ToyDr-W/STM32_orgel_ver1_4/README.md

## STM32_orgel_ver1_4

# 📦 [ARCHIVE / READ-ONLY] STM32 Electronic Music Box Project Backup

**This repository is a read-only archive for backup purposes. It is NOT an active workspace for collaborative development.**

* **Purpose:** To preserve and showcase the original, complete electronic music box project.
* **Structure:** 100% of the original development environment's hierarchy is fully maintained.
* **Source:** Re-hosted from the original author's Google Drive with official permission.

---

### 📦 本リポジトリについて（日本語）

このリポジトリは、開発者ご本家の了解を得て、Google ドライブで公開されているオリジナル版のファイルをそのまま保存した**バックアップ（展示スペース）**です。
約1400余りのファイルからなるプロジェクト一式を、階層構造を100%維持した状態で格納しています。

> [!NOTE]
> ### 📥 最新データのダウンロードについて（v1.2.0正式リリースまで）
> 開発元（名張市つつじが丘おもちゃ病院様）の公開ダウンロードファイルは随時更新されます。次のアップデートがあったときは、本リポジトリへの反映は しばらく様子を見て、安定後に **v1.2.0（安定版）** としてリリース予定です。
> 
> それまでの間、最新の回路図およびプログラム一式をダウンロードするには、
> [ここをクリックしてください。 ⬇️](https://github.com/ToyDr-W/STM32_orgel_ver1_4/archive/refs/heads/main.zip)
> ダウンロード（79.4 MBのZIPファイル）が直ちに開始されます。
>
> ---
>
> ### 📥 Downloading the Latest Data (Prior to v1.2.0 Official Release)
> The file made available for download by the developer (Nabari City Tsutsujigaoka Toy Hospital) is updated periodically. When a new update is released, it will not be immediately incorporated into this repository; instead, we will monitor it for a while, and once it has proven stable, we plan to release it as **v1.2.0 (stable version)**.
> 
> In the meantime, [please click here to download ⬇️](https://github.com/ToyDr-W/STM32_orgel_ver1_4/archive/refs/heads/main.zip) the latest circuit diagrams and the complete set of programs. The download (79.4 MB ZIP file) will begin immediately.
> 

---

### 🔗 開発者ご本家・オリジナルリソース (Original Resources)

最新情報や詳細な解説については、以下の公式ページをご確認ください。

* **開発者公式ブログ:** [名張市つつじが丘おもちゃ病院](https://tutujith.blog.fc2.com/)
* **解説記事:** [ＳＴＭ３２電子オルゴールVer1_4（ＳＰＩフラッシュのＩＳＰ書き込みのサポート）](https://tutujith.blog.fc2.com/blog-entry-1087.html)
* **オリジナル配布元:** [Google ドライブ - プロジェクト一式（ZIP）](https://drive.google.com/file/d/1_EQOB8y7ZNF8W41dpKjoThnxdAZjZsz2/view?usp=sharing)

---

## 🔄 改訂履歴 (Change Log)

<details>
<summary>クリックして詳細を展開 / Click to view details</summary>

### 📄 本リポジトリの更新情報
- **2026/10/17**: v1.0.1 （改版、安定版）2026/10/7 開発元の公開ダウンロードファイル更新を反映
- **2026/10/14**: v1.0.0 （GitHub開始時、安定版）2026/10/4 ＳＰＩフラッシュのＩＳＰ書き込みのサポート

</details>

---

### ⚠️ 注意事項 (Notice)

1. **Issue・Pull Requestについて:** アーカイブ目的のため、コードの修正提案やPull Requestは受け付けておりません。
2. **成果物の取り扱い:** 開発者様のブログ方針に準じ、複製・改変等はフリーですが、改変時はオリジナルと区別できるようにしてください。
