ToyDr-W/STM32_orgel_ver1_4/orgel1_4/wave/readme.txt

ＷＡＶファイルから音源データを生成する手順

①wav2dec.exe でＷＡＶファイルを１０進表現のテキストデータに変換する。
　ｂａｔファイル例　Piano_C3sample256.bat

②Ｅｘｃｅｌに喰わせて折れ線グラフ化し、波形を見る。
　取出したい１周期分のデータをトリミングする。
　Ｅｘｃｅｌファイル例　Piano_C3.xls

③sample256.exe でｄｗ疑似命令のアセンブラソースファイを作成する。
　ｂａｔファイル例　Piano_C3sample256.bat
