ToyDr-W/STM32_orgel_ver1_4/（ポート節約）画像/ＳＴＭ３２電子オルゴールVer1_4（ポート節約）Ｆ０３０Ｆ４Ｐ６ソフト実装ＳＰＩ全体.png

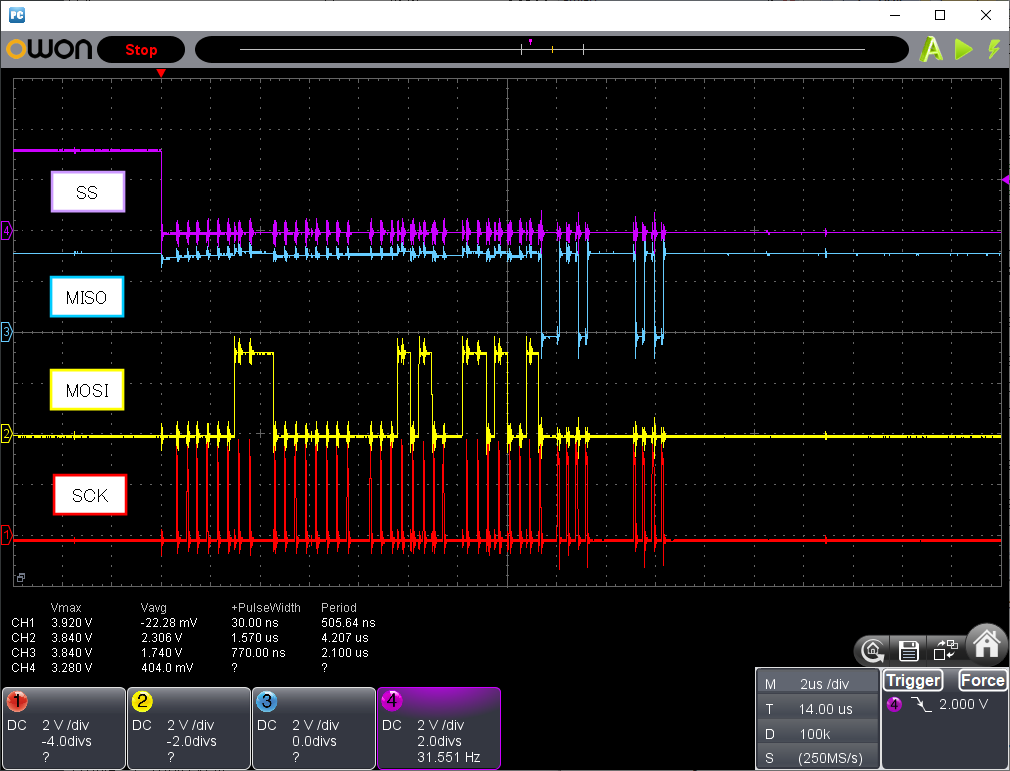
（ポート節約）画像/ＳＴＭ３２電子オルゴールVer1_4（ポート節約）Ｆ０３０Ｆ４Ｐ６ソフト実装ＳＰＩ全体.png
