ToyDr-W/STM32_orgel_ver1_4/（ポート節約）画像/ＳＴＭ３２電子オルゴールVer1_4（ポート節約）Ｆ１０３Ｃ６Ｔ６Ａ内蔵ＳＰＩ拡大２.png

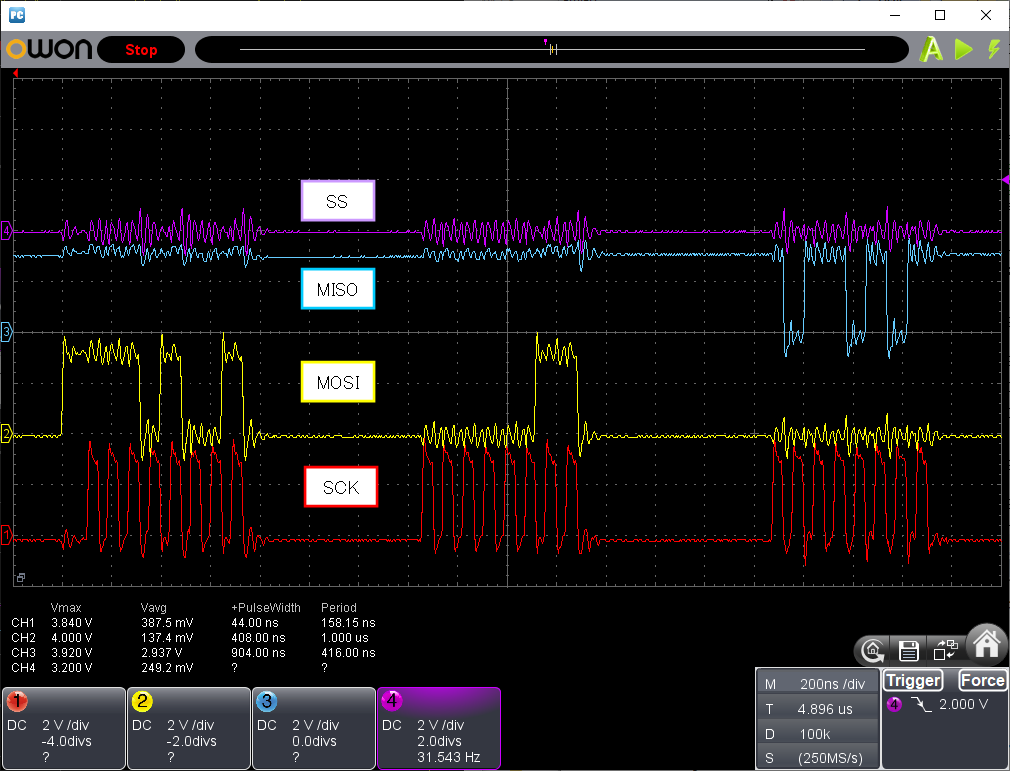
（ポート節約）画像/ＳＴＭ３２電子オルゴールVer1_4（ポート節約）Ｆ１０３Ｃ６Ｔ６Ａ内蔵ＳＰＩ拡大２.png
