ToyDr-W/STM32_orgel_ver1_4/（ポート節約）画像/ＳＴＭ３２電子オルゴールVer1_4（ポート節約）Ｆ１０３Ｃ６Ｔ６Ａ内蔵ＳＰＩ縮小.png

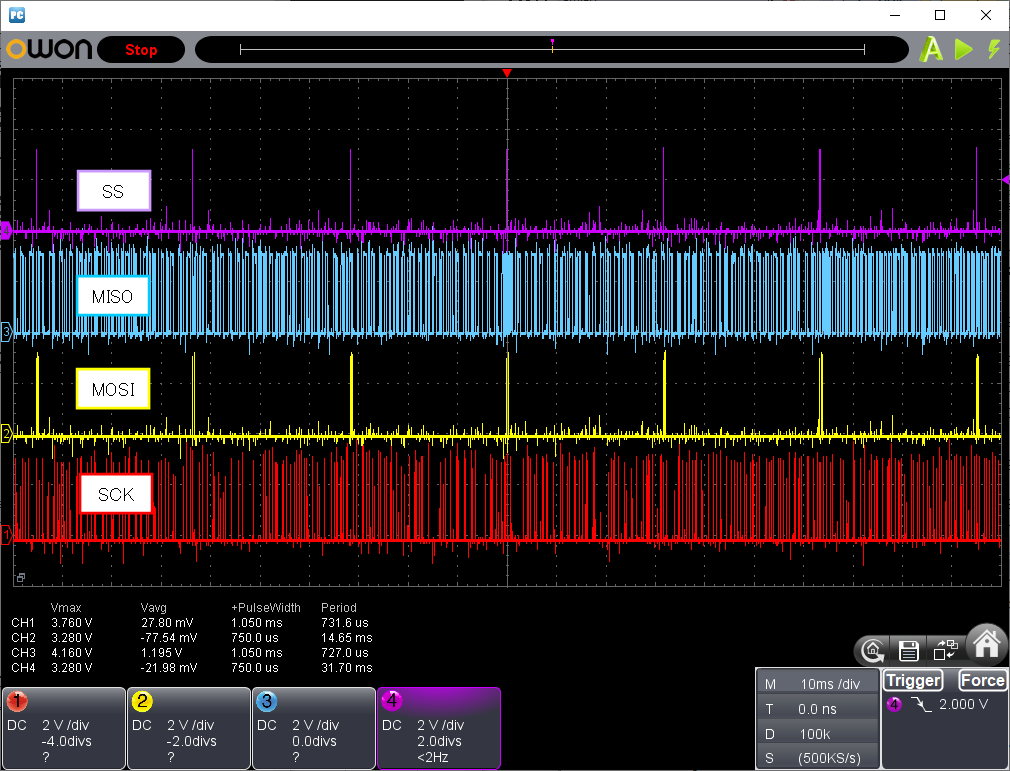
（ポート節約）画像/ＳＴＭ３２電子オルゴールVer1_4（ポート節約）Ｆ１０３Ｃ６Ｔ６Ａ内蔵ＳＰＩ縮小.png
