ToyDr-W/STM32_orgel_ver1_4/（ポート節約）画像/ＳＴＭ３２電子オルゴールVer1_4（ポート節約）Ｒｅａｄコマンドシーケンス.jpg

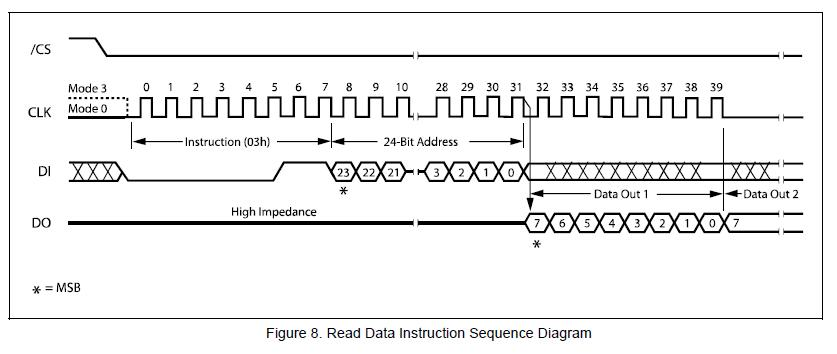
（ポート節約）画像/ＳＴＭ３２電子オルゴールVer1_4（ポート節約）Ｒｅａｄコマンドシーケンス.jpg
