ToyDr-W/STM32_orgel_ver1_4/（ＳＰＩフラッシュのＩＳＰ書込み）画像/ＳＴＭ３２電子オルゴールVer1_4（ＳＰＩフラッシュのＩＳＰ書込み）write実行結果.png

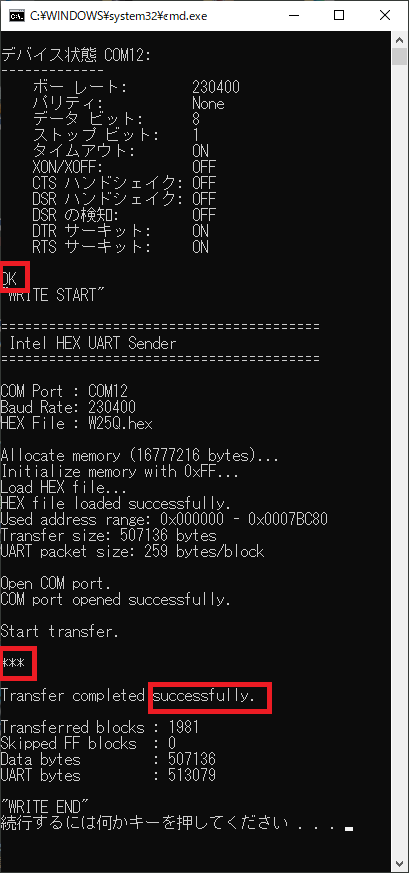
（ＳＰＩフラッシュのＩＳＰ書込み）画像/ＳＴＭ３２電子オルゴールVer1_4（ＳＰＩフラッシュのＩＳＰ書込み）write実行結果.png
