ToyDr-W/STM32_orgel_ver1_4/（ＳＰＩフラッシュのＩＳＰ書込み）画像/ＳＴＭ３２電子オルゴールVer1_4（ＳＰＩフラッシュのＩＳＰ書込み）構成.jpg

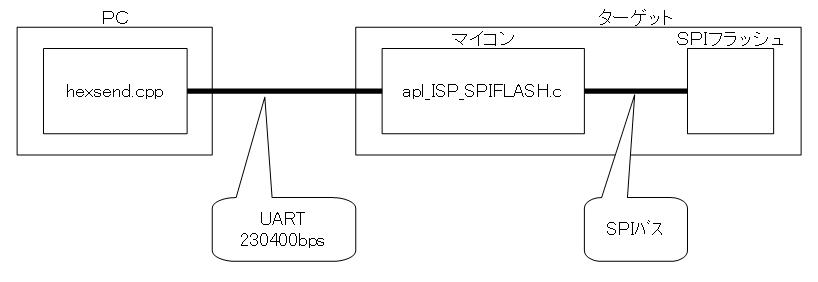
（ＳＰＩフラッシュのＩＳＰ書込み）画像/ＳＴＭ３２電子オルゴールVer1_4（ＳＰＩフラッシュのＩＳＰ書込み）構成.jpg
