ToyDr-W/STM32_orgel_ver1_4/（ＳＰＩ音声複数ｃｈで性能改善）画像/ＳＴＭ３２電子オルゴールVer1_4（ＳＰＩ音声複数ｃｈで性能改善）ＳＰＩ波形３.png

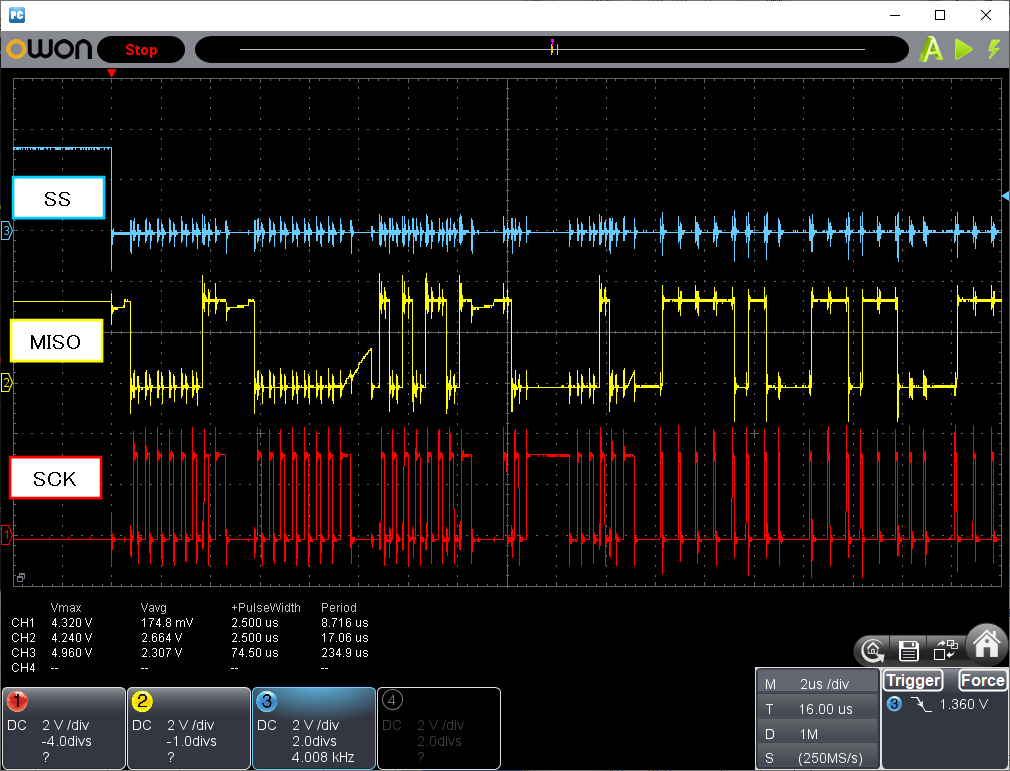
（ＳＰＩ音声複数ｃｈで性能改善）画像/ＳＴＭ３２電子オルゴールVer1_4（ＳＰＩ音声複数ｃｈで性能改善）ＳＰＩ波形３.png
