ToyDr-W/STM32_orgel_ver1_4/ＳＴＭ３２電子オルゴールVer1_4（ＳＴＭ３２Ｆ０３０Ｃ８Ｔ６完成基板）画像/ＳＴＭ３２電子オルゴールVer1_4（ＳＴＭ３２Ｆ０３０Ｃ８Ｔ６完成基板）基板３.JPG

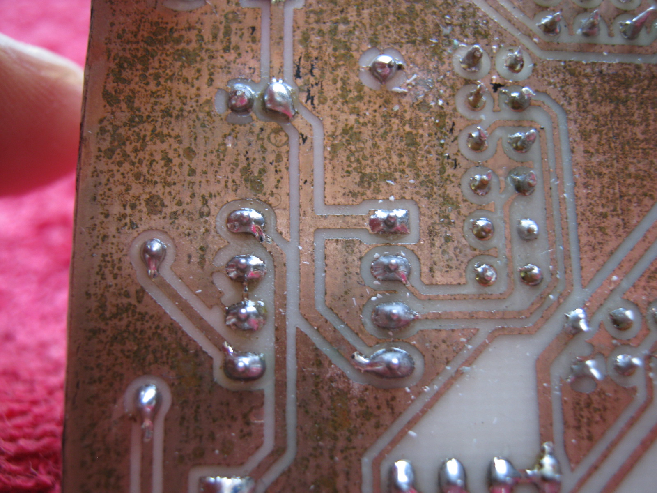
ＳＴＭ３２電子オルゴールVer1_4（ＳＴＭ３２Ｆ０３０Ｃ８Ｔ６完成基板）画像/ＳＴＭ３２電子オルゴールVer1_4（ＳＴＭ３２Ｆ０３０Ｃ８Ｔ６完成基板）基板３.JPG
