ToyDr-W/STM32_orgel_ver1_4/orgel1_4/tool_ikou_song/tool/Release/BuildLog.htm

ビルド ログ

| | リビルド 開始: プロジェクト: tool、構成: Release|Win32

コマンド ライン

一時ファイル "d:\ooizumi\STM\orgel1_3\tool_ikou_song\tool\Release\RSP000001582811144.rsp" を作成しています。内容 :
[
/O2 /Oi /GL /D "WIN32" /D "NDEBUG" /D "_CONSOLE" /D "_UNICODE" /D "UNICODE" /FD /EHsc /MD /Gy /Fo"Release\\" /Fd"Release\vc90.pdb" /W3 /c /Zi /TP .\tool.cpp
]
コマンド ライン "cl.exe @d:\ooizumi\STM\orgel1_3\tool_ikou_song\tool\Release\RSP000001582811144.rsp /nologo /errorReport:prompt" を作成しています。
一時ファイル "d:\ooizumi\STM\orgel1_3\tool_ikou_song\tool\Release\RSP000002582811144.rsp" を作成しています。内容 :
[
/OUT:"D:\ooizumi\STM\orgel1_3\tool_ikou_song\tool\Release\tool.exe" /INCREMENTAL:NO /MANIFEST /MANIFESTFILE:"Release\tool.exe.intermediate.manifest" /MANIFESTUAC:"level='asInvoker' uiAccess='false'" /DEBUG /PDB:"D:\ooizumi\STM\orgel1_3\tool_ikou_song\tool\Release\tool.pdb" /SUBSYSTEM:CONSOLE /OPT:REF /OPT:ICF /LTCG /DYNAMICBASE /NXCOMPAT /MACHINE:X86 kernel32.lib user32.lib gdi32.lib winspool.lib comdlg32.lib advapi32.lib shell32.lib ole32.lib oleaut32.lib uuid.lib odbc32.lib odbccp32.lib

".\Release\tool.obj"
]
コマンド ライン "link.exe @d:\ooizumi\STM\orgel1_3\tool_ikou_song\tool\Release\RSP000002582811144.rsp /NOLOGO /ERRORREPORT:PROMPT" を作成しています。
一時ファイル "d:\ooizumi\STM\orgel1_3\tool_ikou_song\tool\Release\RSP000003582811144.rsp" を作成しています。内容 :
[
/outputresource:".\Release\tool.exe;#1" /manifest

.\Release\tool.exe.intermediate.manifest
]
コマンド ライン "mt.exe @d:\ooizumi\STM\orgel1_3\tool_ikou_song\tool\Release\RSP000003582811144.rsp /nologo" を作成しています。
一時ファイル "d:\ooizumi\STM\orgel1_3\tool_ikou_song\tool\Release\BAT000004582811144.bat" を作成しています。内容 :
[
@echo マニフェスト リソースの最終更新日時: %TIME% (%DATE%) > .\Release\mt.dep
]
コマンド ライン "d:\ooizumi\STM\orgel1_3\tool_ikou_song\tool\Release\BAT000004582811144.bat" を作成しています。

出力ウィンドウ

| | コンパイルしています... tool.cpp リンクしています... コード生成しています。 コード生成が終了しました。 マニフェストを埋め込んでいます...

結果

| | ビルドログは "file://d:\ooizumi\STM\orgel1_3\tool_ikou_song\tool\Release\BuildLog.htm" に保存されました。 tool - エラー 0、警告 0
