ToyDr-W/STM32_orgel_ver1_4/orgel1_4/dev_PWM_F030F4.c

//==============================================
//PWM周期割込み処理
//==============================================
void TIM1_BRK_UP_TRG_COM_IRQHandler(void)
{
	short pcm;				//PCM値

//DBS_H;					//割込み処理開始を表示する
	TIM1->SR=0;				//割込みﾌﾗｸﾞをｸﾘｱする

	//PCM値を取得
	if(buf_read==buf_write) return;		//ﾃﾞｰﾀが無かったら飛ばす
	pcm=buf[buf_read];			//PCM値を取出す
	if(buf_read==(OUT_BUF_N-1)) buf_read=0;	//ﾊﾞｯﾌｧの後尾になったら先頭に戻す
	else buf_read++;			//ﾊﾞｯﾌｧを進める

//**********************************************
#ifdef PWM_3N_2_3				//正相3N､ﾌﾞﾘｯｼﾞ逆相2､ｺﾝﾌﾟﾘ逆相3
	//ﾃﾞｭｰﾃｨｻｲｸﾙを設定
#if BTL<2				//ｼﾝｸﾞﾙ･ｺﾝﾌﾟﾘ出力のとき
	TIM1->CCR3=((long)pcm+32768)*PWM_STEP/65536;
						//正相(逆相)を設定する

#else					//ﾌﾞﾘｯｼﾞ･ﾌﾞﾚｰｷ出力のとき
	if(pcm>0)				//正値のとき
	{
		TIM1->CCR2=0;			//逆相を止める
		TIM1->CCR3=(long)pcm*PWM_STEP/32768;
						//正相を設定する
	}
	else if(pcm<0)				//負値のとき
	{
		TIM1->CCR3=0;			//正相を止める
		TIM1->CCR2=(long)(-pcm)*PWM_STEP/32768;
						//逆相を設定する
	}
	else					//停止のとき
	{
		TIM1->CCR3=0;			//正相を止める
		TIM1->CCR2=0;			//逆相を止める
	}
#endif
#endif

//**********************************************
#ifdef PWM_3N_1N				//正相3N､ﾌﾞﾘｯｼﾞ逆相1N
	//ﾃﾞｭｰﾃｨｻｲｸﾙを設定
#if BTL==0				//ｼﾝｸﾞﾙ出力のとき
	TIM1->CCR3=((long)pcm+32768)*PWM_STEP/65536;
						//正相を設定する
#endif

#if BTL>1				//ﾌﾞﾘｯｼﾞ･ﾌﾞﾚｰｷ出力のとき
	if(pcm>0)				//正値のとき
	{
		TIM1->CCR1=0;			//逆相を止める
		TIM1->CCR3=(long)pcm*PWM_STEP/32768;
						//正相を設定する
	}
	else if(pcm<0)				//負値のとき
	{
		TIM1->CCR3=0;			//正相を止める
		TIM1->CCR1=(long)(-pcm)*PWM_STEP/32768;
						//逆相を設定する
	}
	else					//停止のとき
	{
		TIM1->CCR3=0;			//正相を止める
		TIM1->CCR1=0;			//逆相を止める
	}
#endif
#endif

//**********************************************
#ifdef PWM_3N					//ｼﾝｸﾞﾙ正相3N
	//ﾃﾞｭｰﾃｨｻｲｸﾙを設定
#if BTL==0				//ｼﾝｸﾞﾙ出力のとき
	TIM1->CCR3=((long)pcm+32768)*PWM_STEP/65536;
						//正相を設定する
#endif
#endif

//DBS_L;					//割込み処理終了を表示する
}


//==============================================
//PWM周期を待つ
//==============================================
static void wait_pwm(void)
{

	TIM1->SR=0;				//ｲﾍﾞﾝﾄﾌﾗｸﾞをｸﾘｱする
	while(!(TIM1->SR&TIM_SR_UIF));		//更新ｲﾍﾞﾝﾄを待つ
}


#ifdef	SLEEP_EN			//Sleep機能を実装するとき
//==============================================
//PWMを停止
//==============================================
static void dev_pwm_stop(void)
{

//DBG_C('\n');
//DBG_C('t');
	//DC更新を待つ
//DBG_C('1');
	wait_ms(10);				//10ms間はPWM割込み処理を回す
	TIM1->DIER=0;				//TIM1割込み禁止

//**********************************************
#ifdef PWM_3N_2_3				//正相3N､ﾌﾞﾘｯｼﾞ逆相2､ｺﾝﾌﾟﾘ逆相3
//DBG_C('a');
	//PWMを停止
//DBG_C('2');
	//ﾃﾞｭｰﾃｨｻｲｸﾙを設定
#if BTL==0				//ｼﾝｸﾞﾙ出力のとき
//DBG_C('3');
	while(TIM1->CCR3)			//DCが0になるまで繰返す
	{
		TIM1->CCR3--;			//ﾗﾝﾌﾟ下降
		wait_pwm();			//PWM周期を待つ
	}
#endif

#if BTL==1				//ｺﾝﾌﾟﾘ出力のとき
//DBG_C('4');
	TIM1->CCR3=PWM_STEP/2;			//DCを50%にする
	wait_pwm();				//PWM周期を待つ
	TIM1->CCER=0;				//PWM出力を止める
#endif

#if BTL>1				//ﾌﾞﾘｯｼﾞ･ﾌﾞﾚｰｷ出力のとき
//DBG_C('5');
	TIM1->CCR3=TIM1->CCR2=0;		//DCを0%にする
	wait_pwm();				//PWM周期を待つ
#endif

#if BTL==3				//ﾌﾞﾚｰｷ出力のとき
//DBG_C('6');
	TIM1->CCER&=~(TIM_CCER_CC3NP|TIM_CCER_CC2P);
						//正相と逆相をｱｸﾃｨﾌﾞHにする
#endif
#endif

//**********************************************
#ifdef PWM_3N_1N				//正相3N､ﾌﾞﾘｯｼﾞ逆相1N
//DBG_C('b');
	//PWMを停止
//DBG_C('2');
	//ﾃﾞｭｰﾃｨｻｲｸﾙを設定
#if BTL==0				//ｼﾝｸﾞﾙ出力のとき
//DBG_C('3');
	while(TIM1->CCR3)			//DCが0になるまで繰返す
	{
		TIM1->CCR3--;			//ﾗﾝﾌﾟ下降
		wait_pwm();			//PWM周期を待つ
	}
#endif
#if BTL==1				//ｺﾝﾌﾟﾘ出力のとき
//DBG_C('4');
	TIM1->CCR3=PWM_STEP/2;			//DCを50%にする
	wait_pwm();				//PWM周期を待つ
	TIM1->CCER=0;				//PWM出力を止める
#endif
#if BTL>1				//ﾌﾞﾘｯｼﾞ･ﾌﾞﾚｰｷ出力のとき
//DBG_C('5');
	TIM1->CCR3=TIM1->CCR1=0;		//DCを0%にする
	wait_pwm();				//PWM周期を待つ
#endif
#if BTL==3				//ﾌﾞﾚｰｷ出力のとき
//DBG_C('6');
	TIM1->CCER&=~(TIM_CCER_CC3NP|TIM_CCER_CC1NP);
						//正相と逆相をｱｸﾃｨﾌﾞHにする
#endif
#endif

//**********************************************
#ifdef PWM_3N					//ｼﾝｸﾞﾙ正相3N
//DBG_C('c');
	//PWMを停止
//DBG_C('2');
	//ﾃﾞｭｰﾃｨｻｲｸﾙを設定
#if BTL==0				//ｼﾝｸﾞﾙ出力のとき
//DBG_C('3');
	while(TIM1->CCR3)			//DCが0になるまで繰返す
	{
		TIM1->CCR3--;			//ﾗﾝﾌﾟ下降
		wait_pwm();			//PWM周期を待つ
	}
#endif
#endif

//DBG_C('9');
}
#endif


//==============================================
//PWMを再開
//==============================================
static void dev_pwm_start(void)
{

//DBG_C('\n');
//DBG_C('r');

//**********************************************
#ifdef PWM_3N_2_3				//正相3N､ﾌﾞﾘｯｼﾞ逆相2､ｺﾝﾌﾟﾘ逆相3
//DBG_C('a');
	//ﾃﾞｭｰﾃｨｻｲｸﾙを設定
#if BTL==0				//ｼﾝｸﾞﾙ出力のとき
//DBG_C('1');
	while(TIM1->CCR3++<PWM_STEP/2)		//ﾗﾝﾌﾟ上昇
	{
		wait_pwm();			//PWM周期を待つ
	}
#endif

#if BTL==1				//ｺﾝﾌﾟﾘ出力のとき
//DBG_C('2');
	TIM1->CCER|=TIM_CCER_CC3NP|TIM_CCER_CC3NE|TIM_CCER_CC3P|TIM_CCER_CC3E;
						//CH3NとCH3をｱｸﾃｨﾌﾞLでﾋﾟﾝ出力
#endif

#if BTL==3				//ﾌﾞﾚｰｷ出力のとき
//DBG_C('3');
	TIM1->CCER|=TIM_CCER_CC3NP|TIM_CCER_CC2P;
						//CH3NとCH2をｱｸﾃｨﾌﾞLにする
#endif
#endif

//**********************************************
#ifdef PWM_3N_1N				//正相3N､ﾌﾞﾘｯｼﾞ逆相1N
//DBG_C('b');
	//ﾃﾞｭｰﾃｨｻｲｸﾙを設定
#if BTL==0				//ｼﾝｸﾞﾙ出力のとき
//DBG_C('1');
	while(TIM1->CCR3++<PWM_STEP/2)		//ﾗﾝﾌﾟ上昇
	{
		wait_pwm();			//PWM周期を待つ
	}
#endif

#if BTL==3				//ﾌﾞﾚｰｷ出力のとき
//DBG_C('3');
	TIM1->CCER|=TIM_CCER_CC3NP|TIM_CCER_CC1NP;
						//CH3NとCH1NをｱｸﾃｨﾌﾞLにする
#endif
#endif

//**********************************************
#ifdef PWM_3N					//ｼﾝｸﾞﾙ正相3N
//DBG_C('c');
	//ﾃﾞｭｰﾃｨｻｲｸﾙを設定
#if BTL==0				//ｼﾝｸﾞﾙ出力のとき
//DBG_C('1');
	while(TIM1->CCR3++<PWM_STEP/2)		//ﾗﾝﾌﾟ上昇
	{
		wait_pwm();			//PWM周期を待つ
	}
#endif
#endif

	//PWMを再開
//DBG_C('8');
	TIM1->DIER=TIM_DIER_UIE;		//TIM1更新割込み許可
//DBG_C('9');
}


//==============================================
//PWM初期設定
//==============================================
static void pwm_init(void)
{

//DBG_C('<');
//DBG_C('p');
	//PWM設定(TIM1)
	RCC->APB2ENR|=RCC_APB2ENR_TIM1EN;	//TIM1にｸﾛｯｸ供給
	//TIM1->CR1のCMSﾋﾞｯﾄは00(ｴｯｼﾞｱﾗｲﾝﾄﾞﾓｰﾄﾞ)初期値
	//TIM1->SMCRのSMSﾋﾞｯﾄは000(ｽﾚｰﾌﾞﾓｰﾄﾞ無効)初期値
	//TIM1->PSCは0(ｸﾛｯｸ分周しない)初期値	//ｸﾛｯｸはSYSCLK
#if BTL==2				//ﾌﾞﾘｯｼﾞ出力のとき
	TIM1->ARR=PWM_STEP-1+PWM_DB_BRG;	//PWM周期(ﾃﾞｯﾄﾞﾊﾞﾝﾄﾞを考慮)
#else
	TIM1->ARR=PWM_STEP-1;			//PWM周期
#endif
	TIM1->BDTR|=TIM_BDTR_AOE;		//自動出力可
	TIM1->CNT=0;				//ｶｳﾝﾀをｸﾘｱ
	TIM1->CR1|=TIM_CR1_CEN;			//ｶｳﾝﾀ有効
	TIM1->CCMR2|=(TIM_CCMR2_OC3M_2|TIM_CCMR2_OC3M_1|TIM_CCMR2_OC3PE);
						//CH3をPWMﾓｰﾄﾞ1､ﾌﾟﾘﾛｰﾄﾞ有効

//**********************************************
#ifdef PWM_3N_2_3				//正相3N､ﾌﾞﾘｯｼﾞ逆相2､ｺﾝﾌﾟﾘ逆相3
//DBG_C('a');
#if BTL==0				//ｼﾝｸﾞﾙ出力のとき
//DBG_C('1');
	TIM1->CCER|=TIM_CCER_CC3NE;		//CH3Nをﾋﾟﾝ出力
	GPIO_AF(PWM_F_GPIO,PWM_F_BIT,PWM_F_AF);	//PWM正相を交代機能設定
#endif

#if BTL==1				//ｺﾝﾌﾟﾘ出力のとき
//DBG_C('2');
	TIM1->CCR3=PWM_STEP/2;			//CH3のDCを50%
	GPIO_AF(PWM_F_GPIO,PWM_F_BIT,PWM_F_AF);	//PWM正相を交代機能設定
	GPIO_AF(PWM_C_GPIO,PWM_C_BIT,PWM_C_AF);	//PWMｺﾝﾌﾟﾘを交代機能設定
#endif

#if BTL>1				//ﾌﾞﾘｯｼﾞ出力､ﾌﾞﾚｰｷ出力のとき
//DBG_C('3');
	TIM1->CCMR1|=(TIM_CCMR1_OC2M_2|TIM_CCMR1_OC2M_1|TIM_CCMR1_OC2PE);
						//CH2をPWMﾓｰﾄﾞ1､ﾌﾟﾘﾛｰﾄﾞ有効
	TIM1->CCER|=TIM_CCER_CC3NE|TIM_CCER_CC2E;
						//CH3NとCH2をﾋﾟﾝ出力
	GPIO_AF(PWM_F_GPIO,PWM_F_BIT,PWM_F_AF);	//PWM正相を交代機能設定
	GPIO_AF(PWM_R_GPIO,PWM_R_BIT,PWM_R_AF);	//PWM逆相を交代機能設定
#endif
#endif

//**********************************************
#ifdef PWM_3N_1N				//正相3N､ﾌﾞﾘｯｼﾞ逆相1N
//DBG_C('b');
#if BTL==0				//ｼﾝｸﾞﾙ出力のとき
//DBG_C('1');
	TIM1->CCER|=TIM_CCER_CC3NE;		//CH3Nをﾋﾟﾝ出力
	GPIO_AF(PWM_F_GPIO,PWM_F_BIT,PWM_F_AF);	//PWM正相を交代機能設定
#endif

#if BTL>1				//ﾌﾞﾘｯｼﾞ出力､ﾌﾞﾚｰｷ出力のとき
//DBG_C('3');
	TIM1->CCMR1|=(TIM_CCMR1_OC1M_2|TIM_CCMR1_OC1M_1|TIM_CCMR1_OC1PE);
						//CH1をPWMﾓｰﾄﾞ1､ﾌﾟﾘﾛｰﾄﾞ有効
	TIM1->CCER|=TIM_CCER_CC3NE|TIM_CCER_CC1NE;
						//CH3NとCH1Nをﾋﾟﾝ出力
	GPIO_AF(PWM_F_GPIO,PWM_F_BIT,PWM_F_AF);	//PWM正相を交代機能設定
	GPIO_AF(PWM_R_GPIO,PWM_R_BIT,PWM_R_AF);	//PWM逆相を交代機能設定
#endif
#endif

//**********************************************
#ifdef PWM_3N					//ｼﾝｸﾞﾙ正相3N
//DBG_C('c');
#if BTL==0				//ｼﾝｸﾞﾙ出力のとき
//DBG_C('1');
	TIM1->CCER|=TIM_CCER_CC3NE;		//CH3Nをﾋﾟﾝ出力
	GPIO_AF(PWM_F_GPIO,PWM_F_BIT,PWM_F_AF);	//PWM正相を交代機能設定
#endif
#endif

//DBG_C('9');
	//PWM周期割込み設定
	NVIC->ISER[0]=(1<<TIM1_BRK_UP_TRG_COM_IRQn);
						//TIM1割込み許可
//DBG_C('>');
	dev_pwm_start();			//PWMを開始する
}
