ToyDr-W/STM32_orgel_ver1_4/orgel1_4/dev_PWM_F030Cx.c

//==============================================
//PWM周期割込み処理
//==============================================
void TIM1_BRK_UP_TRG_COM_IRQHandler(void)
{
	short pcm;				//PCM値

//DBS_H;					//割込み処理開始を表示する
	TIM1->SR=0;				//割込みﾌﾗｸﾞをｸﾘｱする

	//PCM値を取得
	if(buf_read==buf_write) return;		//ﾃﾞｰﾀが無かったら飛ばす
	pcm=buf[buf_read];			//PCM値を取出す
	if(buf_read==(OUT_BUF_N-1)) buf_read=0;	//ﾊﾞｯﾌｧの後尾になったら先頭に戻す
	else buf_read++;			//ﾊﾞｯﾌｧを進める

	//ﾃﾞｭｰﾃｨｻｲｸﾙを設定

#if BTL<2				//ｼﾝｸﾞﾙ･ｺﾝﾌﾟﾘ出力のとき
	TIM1->CCR1=((long)pcm+32768)*PWM_STEP/65536;
						//正相(逆相)を設定する

#else					//ﾌﾞﾘｯｼﾞ･ﾌﾞﾚｰｷ出力のとき
	if(pcm>0)				//正値のとき
	{
		TIM1->CCR4=0;			//逆相を止める
		TIM1->CCR1=(long)pcm*PWM_STEP/32768;
						//正相を設定する
	}
	else if(pcm<0)				//負値のとき
	{
		TIM1->CCR1=0;			//正相を止める
		TIM1->CCR4=(long)(-pcm)*PWM_STEP/32768;
						//逆相を設定する
	}
	else					//停止のとき
	{
		TIM1->CCR1=0;			//正相を止める
		TIM1->CCR4=0;			//逆相を止める
	}
#endif
//DBS_L;					//割込み処理終了を表示する
}


//==============================================
//PWM周期を待つ
//==============================================
static void wait_pwm(void)
{

	TIM1->SR=0;				//ｲﾍﾞﾝﾄﾌﾗｸﾞをｸﾘｱする
	while(!(TIM1->SR&TIM_SR_UIF));		//更新ｲﾍﾞﾝﾄを待つ
}


#ifdef	SLEEP_EN			//Sleep機能を実装するとき
//==============================================
//PWMを停止
//==============================================
static void dev_pwm_stop(void)
{

//DBG_C('\n');
//DBG_C('s');
	//DC更新を待つ
//DBG_C('1');
	wait_ms(10);				//10ms間はPWM割込み処理を回す

	//PWMを停止
//DBG_C('2');
	TIM1->DIER=0;				//TIM1割込み禁止

	//ﾃﾞｭｰﾃｨｻｲｸﾙを設定

#if BTL==0				//ｼﾝｸﾞﾙ出力のとき
//DBG_C('3');
	while(TIM1->CCR1)			//DCが0になるまで繰返す
	{
		TIM1->CCR1--;			//ﾗﾝﾌﾟ下降
		wait_pwm();			//PWM周期を待つ
	}
#endif

#if BTL==1				//ｺﾝﾌﾟﾘ出力のとき
//DBG_C('4');
	TIM1->CCR1=PWM_STEP/2;			//DCを50%にする
	wait_pwm();				//PWM周期を待つ
	TIM1->CCER=0;				//PWM出力を止める
#endif

#if BTL>1				//ﾌﾞﾘｯｼﾞ･ﾌﾞﾚｰｷ出力のとき
//DBG_C('5');
	TIM1->CCR1=TIM1->CCR4=0;		//DCを0%にする
	wait_pwm();				//PWM周期を待つ
#endif

#if BTL==3				//ﾌﾞﾚｰｷ出力のとき
	TIM1->CCER&=~(TIM_CCER_CC1P|TIM_CCER_CC4P);
						//正相と逆相をｱｸﾃｨﾌﾞHにする
#endif
//DBG_C('6');
}
#endif


//==============================================
//PWMを再開
//==============================================
static void dev_pwm_start(void)
{

//DBG_C('\n');
//DBG_C('r');

	//ﾃﾞｭｰﾃｨｻｲｸﾙを設定
#if BTL==0				//ｼﾝｸﾞﾙ出力のとき
//DBG_C('1');
	while(TIM1->CCR1++<PWM_STEP/2)		//ﾗﾝﾌﾟ上昇
	{
		wait_pwm();			//PWM周期を待つ
	}
#endif

#if BTL==1				//ｺﾝﾌﾟﾘ出力のとき
//DBG_C('2');
	TIM1->CCER|=TIM_CCER_CC1E|TIM_CCER_CC1NE;
						//正相と逆相をﾋﾟﾝ出力
#endif

#if BTL==3				//ﾌﾞﾚｰｷ出力のとき
//DBG_C('3');
	TIM1->CCER|=TIM_CCER_CC1P|TIM_CCER_CC4P;//正相と逆相をｱｸﾃｨﾌﾞLにする
#endif

	//PWMを再開
//DBG_C('4');
	TIM1->DIER=TIM_DIER_UIE;		//TIM1更新割込み許可
//DBG_C('5');
}


//==============================================
//PWM初期設定
//==============================================
static void pwm_init(void)
{

//DBG_C('p');
	//PWM設定(TIM1)
	RCC->APB2ENR|=RCC_APB2ENR_TIM1EN;	//TIM1にｸﾛｯｸ供給
	//TIM1->CR1のCMSﾋﾞｯﾄは00(ｴｯｼﾞｱﾗｲﾝﾄﾞﾓｰﾄﾞ)初期値
	//TIM1->SMCRのSMSﾋﾞｯﾄは000(ｽﾚｰﾌﾞﾓｰﾄﾞ無効)初期値
	//TIM1->PSCは0(ｸﾛｯｸ分周しない)初期値	//ｸﾛｯｸはSYSCLK
#if BTL==2				//ﾌﾞﾘｯｼﾞ出力のとき
	TIM1->ARR=PWM_STEP-1+PWM_DB_BRG;	//PWM周期(ﾃﾞｯﾄﾞﾊﾞﾝﾄﾞを考慮)
#else
	TIM1->ARR=PWM_STEP-1;			//PWM周期
#endif
	TIM1->BDTR|=TIM_BDTR_AOE;		//自動出力可
	TIM1->CNT=0;				//ｶｳﾝﾀをｸﾘｱ
	TIM1->CR1|=TIM_CR1_CEN;			//ｶｳﾝﾀ有効
//DBG_C('t');

	//PWM設定(TIM1_CH1)
	TIM1->CCMR1|=(TIM_CCMR1_OC1M_2|TIM_CCMR1_OC1M_1|TIM_CCMR1_OC1PE);
						//CH1をPWMﾓｰﾄﾞ1､ﾌﾟﾘﾛｰﾄﾞ有効
	TIM1->CCER|=TIM_CCER_CC1E;		//CH1をﾋﾟﾝ出力
	GPIO_AF(PWM_F_GPIO,PWM_F_BIT,PWM_F_AF);	//PWM正相を交代機能設定

#if BTL==1				//ｺﾝﾌﾟﾘ出力のとき
//DBG_C('c');
	TIM1->CCR1=PWM_STEP/2;			//CH1のDCを50%
	TIM1->BDTR|=PWM_DB_CMP;			//ﾃﾞｯﾄﾞﾀｲﾑ設定
	TIM1->CCER|=TIM_CCER_CC1NE;		//CH1Nをﾋﾟﾝ出力
	GPIO_AF(PWM_C_GPIO,PWM_C_BIT,PWM_C_AF);	//PWMｺﾝﾌﾟﾘを交代機能設定
#endif

	//PWM設定(TIM1_CH4)
#if BTL>1				//ﾌﾞﾘｯｼﾞ出力､ﾌﾞﾚｰｷ出力のとき
//DBG_C('b');
	TIM1->CCMR2|=(TIM_CCMR2_OC4M_2|TIM_CCMR2_OC4M_1|TIM_CCMR2_OC4PE);
						//CH4をPWMﾓｰﾄﾞ1､ﾌﾟﾘﾛｰﾄﾞ有効
	TIM1->CCER|=TIM_CCER_CC4E;		//CH4をﾋﾟﾝ出力
	GPIO_AF(PWM_R_GPIO,PWM_R_BIT,PWM_R_AF);	//PWM逆相を交代機能設定
#endif

#if BTL==3				//ﾌﾞﾚｰｷ出力のとき
//DBG_C('k');
	TIM1->CCER|=TIM_CCER_CC1P|TIM_CCER_CC4P;//CH1とCH4をｱｸﾃｨﾌﾞLにする
#endif
//DBG_C('q');

	//PWM周期割込み設定
	NVIC->ISER[0]=(1<<TIM1_BRK_UP_TRG_COM_IRQn);
						//TIM1割込み許可
//DBG_C('i');
	dev_pwm_start();			//PWMを開始する
}
