ToyDr-W/STM32_orgel_ver1_4/orgel1_4/orgel_SW_L010F4/orgel_cnf.h

#define SYS_CLK 48 
#define BTL 0 
#define PWM_STEP 1024 
#define PWM_FRQ (SYS_CLK*1000/PWM_STEP) 
#define PWM_PR (PWM_STEP/SYS_CLK) 
#define PWM_DB_BRG 10 
#define OUT_BUF_N 50 
#define SPI_BUF_N 8 
#define SONG_PS 1 
#define KOYUU_PR 32 
#define VOICEN0_VOL 100 
#define VOICEN1_VOL 100 
#define VOICEN2_VOL 100 
#define VOICEI_VOL 100 
#define VOICEC_VOL 100 
#define VOICES0_VOL 100 
#define VOICES1_VOL 100 
#define VOICES2_VOL 100 
#define ORGEL_VOL 100 
#define KB0_VOL 100 
#define KB1_VOL 100 
#define VOICE_N 0 
#define VOICE_I 0 
#define VOICE_C 0 
#define VOICE_S 1 
#define PART_N 0 
#define KB_N 0 
