ToyDr-W/STM32_orgel_ver1_4/orgel1_4/orgel_KB_F030C8/orgel_cnf.h

#define SYS_CLK 64 
#define BTL 0 
#define PWM_STEP 1024 
#define PWM_FRQ (SYS_CLK*1000/PWM_STEP) 
#define PWM_PR (PWM_STEP/SYS_CLK) 
#define PWM_DB_CMP 10 
#define PWM_DB_BRG 10 
#define OUT_BUF_N 50 
#define SPI_BUF_N 8 
#define SONG_PS 2 
#define KOYUU_PR 32 
#define VOICEN0_VOL 100 
#define VOICEN1_VOL 100 
#define VOICEN2_VOL 100 
#define VOICEI_VOL 100 
#define VOICEC_VOL 100 
#define VOICES0_VOL 100 
#define VOICES1_VOL 100 
#define VOICES2_VOL 100 
#define ORGEL_VOL 60 
#define KB0_VOL 60 
#define KB1_VOL 60 
#define VOICE_N 0 
#define VOICE_I 0 
#define VOICE_C 0 
#define VOICE_S 0 
#define PART_N 2 
#define KB_N 2 
#define KB_PSN (100000000/30/PWM_PR/SONG_PS/8+5)/10 
#define KB_EPSENV (23000*10/PWM_PR/SONG_PS+5)/10 
#define KB_PPSPIT (1000*10/PWM_PR/SONG_PS+5)/10 
